noshpotosh/keep/docs/renders/enclosed-hero-chalk.png

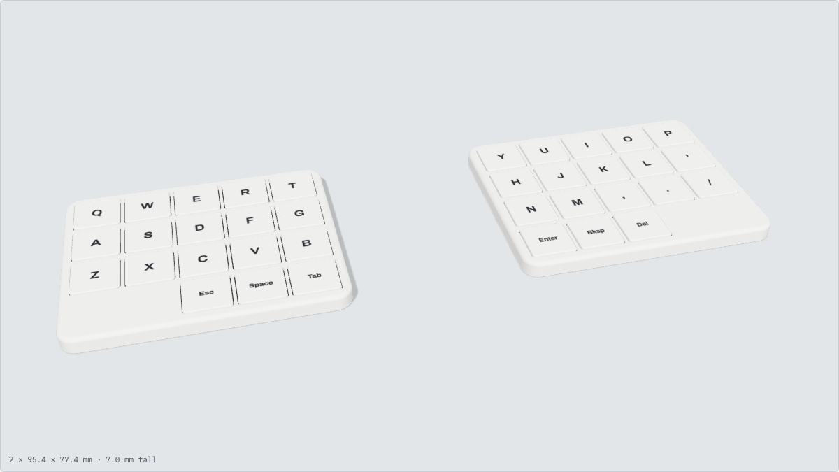
docs/renders/enclosed-hero-chalk.png
