noshpotosh/keep/docs/renders/enclosed-hero-graphite-exploded.png

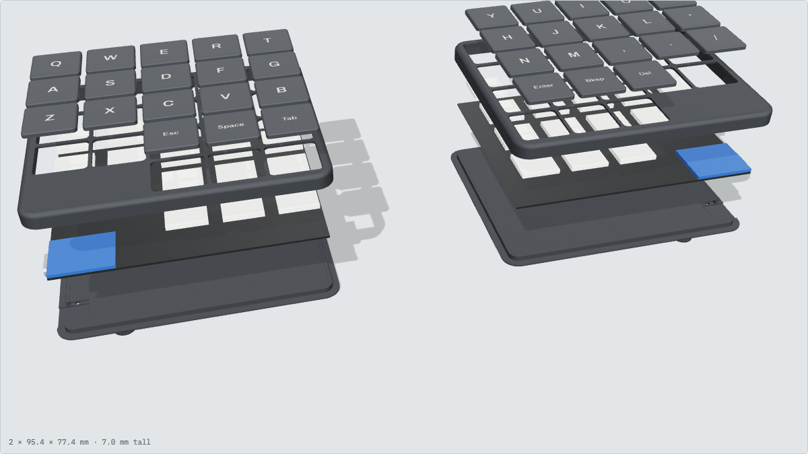
docs/renders/enclosed-hero-graphite-exploded.png
