noshpotosh/keep/docs/renders/enclosed-hero-graphite.png

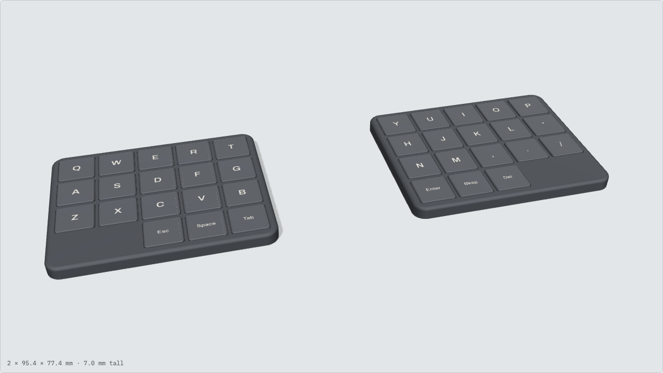
docs/renders/enclosed-hero-graphite.png
