noshpotosh/keep/docs/renders/enclosed-side-chalk.png

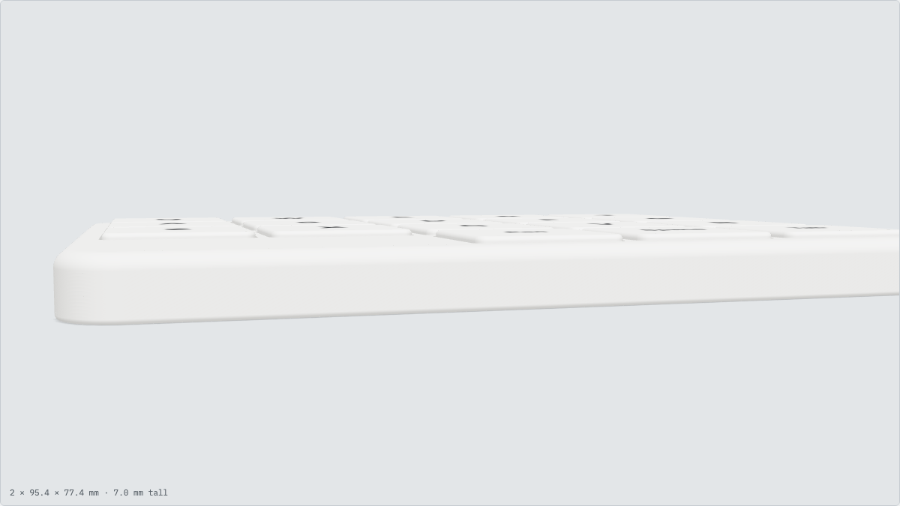
docs/renders/enclosed-side-chalk.png
