noshpotosh/keep/docs/renders/hero-chalk.png

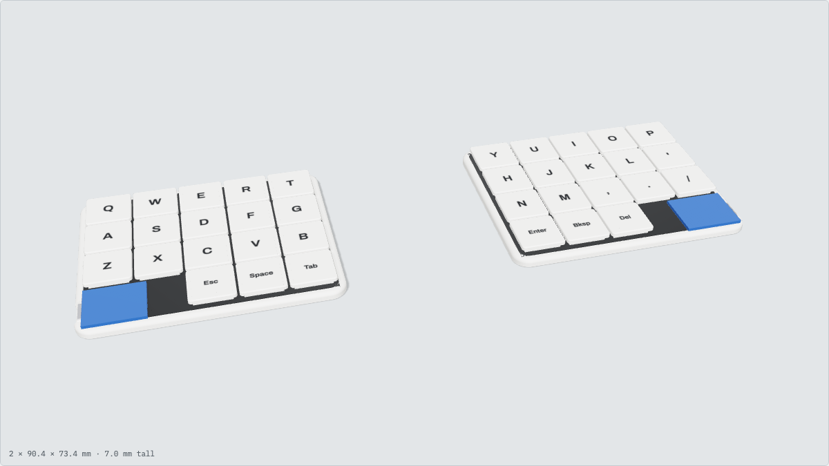
docs/renders/hero-chalk.png
