noshpotosh/keep/docs/renders/hero-signal.png

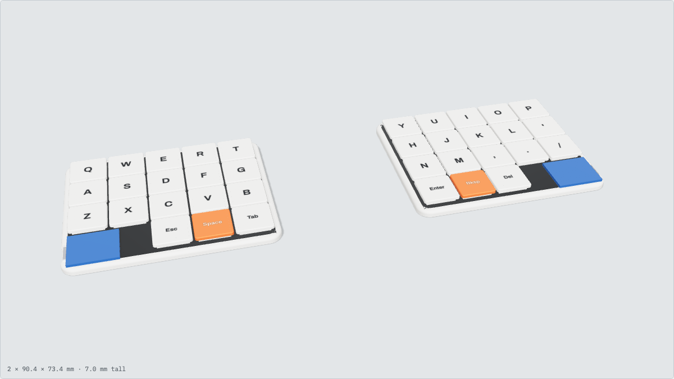
docs/renders/hero-signal.png
