noshpotosh/keep/docs/renders/side-graphite.png

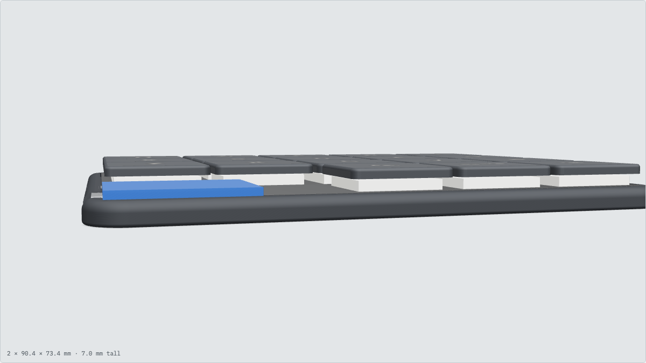
docs/renders/side-graphite.png
