noshpotosh/keep/docs/renders/top-graphite.png

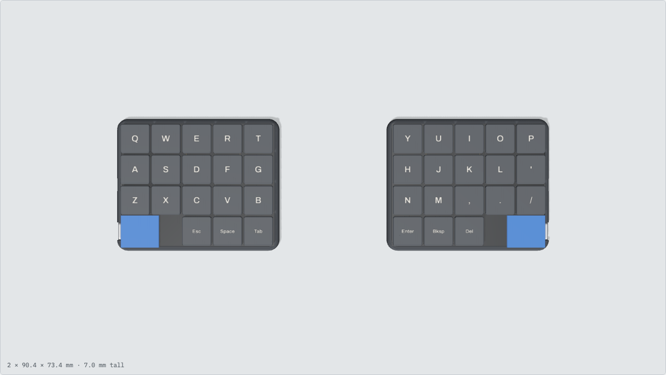
docs/renders/top-graphite.png
