noshpotosh/keep/docs/renders/under-graphite.png

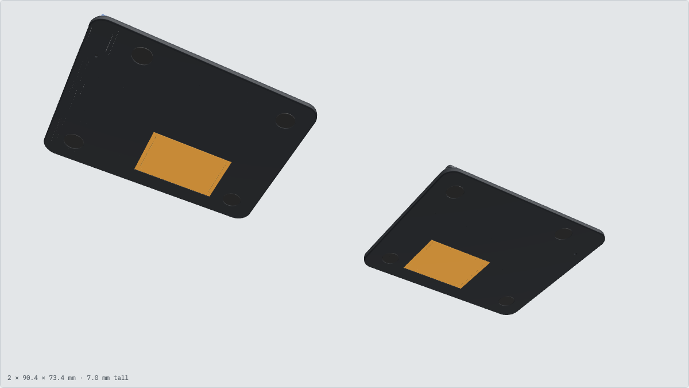
docs/renders/under-graphite.png
