noshpotosh/keep/docs/bom.md

# Bill of materials (full keyboard, both halves)

| Qty | Part | Notes / source |
|---|---|---|
| 2 (+3 spare) | PCB, 0.8 mm FR4, ENIG, reversible (one design for both halves) | JLCPCB, minimum order 5 |
| 36 (+14 spare = 50) | Kailh PG1316S switch | [Holykeebs](https://holykeebs.com/products/kailh-pg1316s-butterfly-switch-10-pack), 10-packs |
| 36 (+4 spare) | PG1316S keycaps, 1U | [Selected Kailh caps via Holykeebs](https://holykeebs.com/products/kailh-pg1316s-keycaps) |
| 36 (+10) | 1N4148WS diode, SOD-323 | LCSC / AliExpress |
| 2 | Seeed XIAO nRF52840 | [Seeed](https://wiki.seeedstudio.com/XIAO_BLE/) |
| 2 | LiPo pouch, 2.5 mm, about 100 mAh, with protection | 252030 class. Record the exact model in [requirements](00-requirements.md#battery) |
| 2 | SMD side slide power switch | e.g. MSK-12C02 |
| 8 | M2 × 3 mm screws + M2 heat-set inserts | or 6 × 1 mm magnets |
| 1 | PG1316S practice board | [Holykeebs](https://holykeebs.com/products/pg1316s-practice-board) |
| — | Kapton tape, 0.5 mm Poron foam, thin rubber feet | |
| — | Filament or resin for the case | |

## Tools
- Fine-tip soldering iron (temperature controlled), flux, and 0.3–0.5 mm solder
- Multimeter, tweezers, calipers, flush cutters
