noshpotosh/keep/assets/pg1316s/3d/PG1316S-assembly.STEP

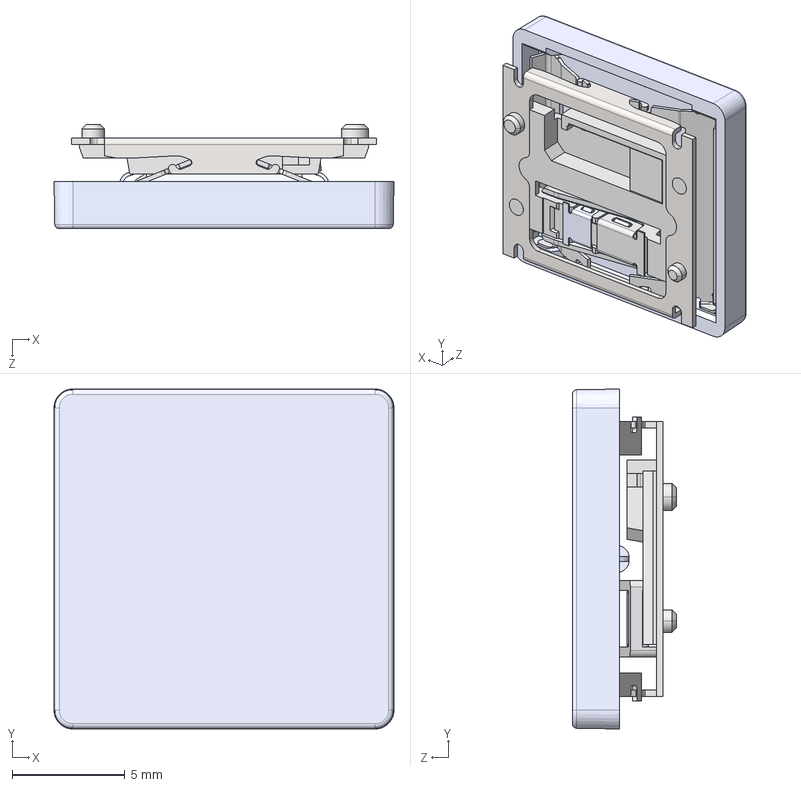
[picture p10: CAD file, 2026-10-22]
assets/pg1316s/3d/PG1316S-assembly.STEP
15.1 x 15.1 x 4.63 mm
1316S-基座卡件
PG1316S-價釱
驱动杆
す算殤
嶺銅
PG1316S-动接触片-带触点
PG1316S-静片-带触点
す算殤-B
瑩簽
