noshpotosh/keep/cad/out/keyboard-enclosed.step

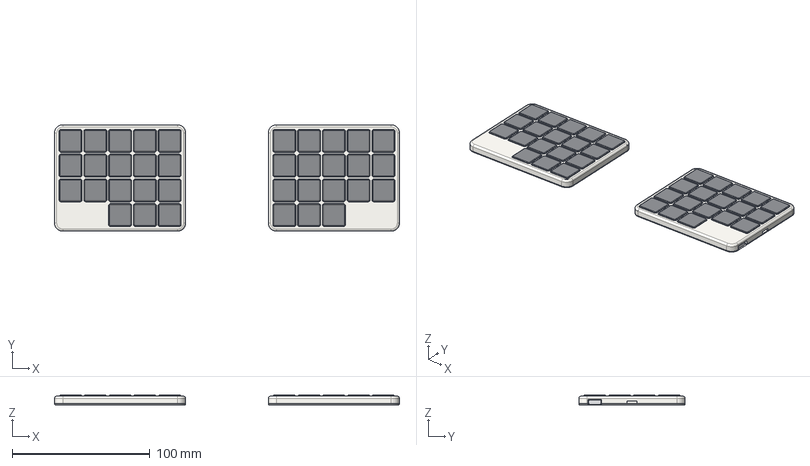
[picture p11: CAD file, 2026-10-22]
cad/out/keyboard-enclosed.step
250.8 x 77.4 x 7.00 mm
plate x 2
foot x 8
cover x 2
pcb x 2
xiao_pcb x 2
xiao_shield x 2
usb_c x 2
power_switch x 2
battery x 2
switch x 36
diode x 36
cap_0_0 x 2
cap_1_0 x 2
cap_2_0 x 2
cap_3_0 x 2
cap_4_0 x 2
cap_0_1 x 2
cap_1_1 x 2
cap_2_1 x 2
cap_3_1 x 2
cap_4_1 x 2
cap_0_2 x 2
cap_1_2 x 2
cap_2_2 x 2
cap_3_2 x 2
cap_4_2 x 2
cap_2_3 x 2
cap_3_3 x 2
cap_4_3 x 2
