noshpotosh/keep/assets/pg1316s/3d/PG1316S-keycap-normal.step

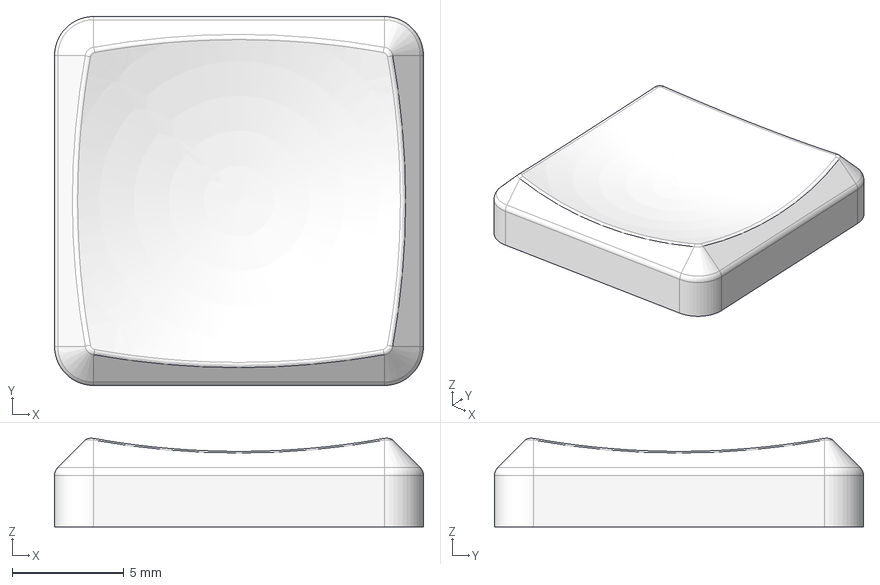
[picture p12: CAD file, 2026-10-22]
assets/pg1316s/3d/PG1316S-keycap-normal.step
16.5 x 16.5 x 3.96 mm
