noshpotosh/keep/(commit log)

2026-10-21 docs: initial build plan
    Requirements, layout/matrix, PCB, firmware, case, assembly, BOM and
    resources for an ultra-thin 36-key PG1316S wireless split.
2026-10-22 docs: update build plan, add CAD model, part assets, and renders
    [PG1316S-assembly.STEP, PG1316S-keycap-normal.step, keyboard-enclosed.step, keyboard.step]
